ninjamar/click-to-go-robot/docs/README.md

# Documentation

| If you want... | Read |
|---|---|
| What was built, what it showed, and the lessons for the next build | [prototype-report-abridged.md](prototype-report-abridged.md) |
| To set up, run, debug or change the code | [technical-reference.md](technical-reference.md)|

Both describe the `master` branch as of October 2026. Where they disagree with the code, the code wins; please fix the document.

Photos used in the report are in `img/`.
