ninjamar/click-to-go-robot/cad/encoder_disk.stl

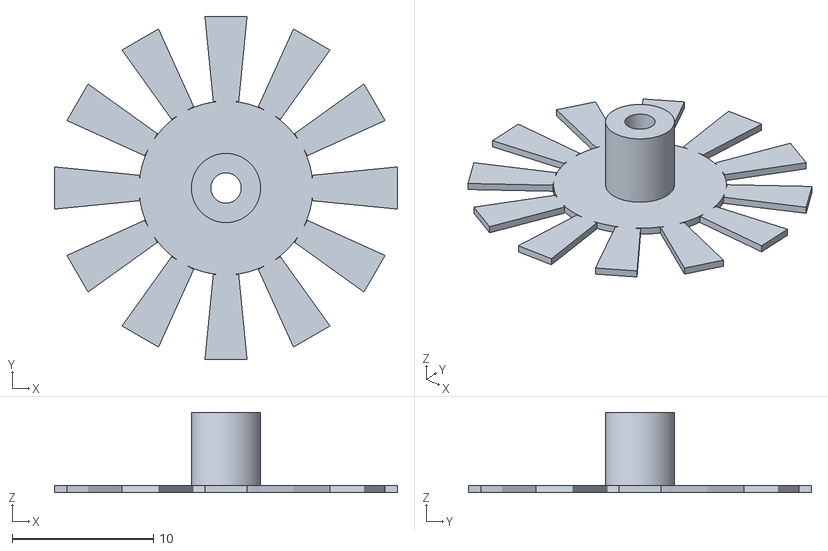
[picture p4: CAD file, 2026-08-12]
cad/encoder_disk.stl
24.3 x 24.3 x 5.70
