ninjamar/click-to-go-robot/motor_control_system/src/main.cpp

#include "config.hpp"
#include "macros.hpp"
#include "motor_driver.hpp"
#include "odometer_driver.hpp"
#include "serial_protocol.hpp"
#include <Arduino.h>
#include <math.h>

MotorDriver motorDriver(MOTOR_A_EN_PIN, MOTOR_A_IN1_PIN, MOTOR_A_IN2_PIN, MOTOR_B_EN_PIN, MOTOR_B_IN1_PIN, MOTOR_B_IN2_PIN);
OdometerDriver odometerDriver(ENCODER_MOTORA_CH_A_PIN, ENCODER_MOTORA_CH_B_PIN, ENCODER_MOTORB_CH_A_PIN, ENCODER_MOTORB_CH_B_PIN);
SerialProtocol serialProtocol(Serial);

// Command queue state
CommandPacket queue[QUEUE_SIZE]; // NOLINT(modernize-avoid-c-arrays)
// Circular buffer; avoids shifting every element on pop.
uint8_t queueHead = 0; // index of oldest item
uint8_t queueCount = 0; // number of items in queue
// tail = index where new item should be added

// Currently executing command
bool isActive = false;
CommandPacket activeCommand;
unsigned long activeStartTime = 0;
unsigned long lastTickTime = 0;

// Progress of the current chain of same-op, same-direction distance commands.
// Not reset between blended commands; accumulatedRad is reused across
// ROTATE_ANGLE and DEBUG_RUN_N_ROTATIONS (never both active at once).
float accumulatedM = 0.0f;
float accumulatedRad = 0.0f;
float chainBase = 0.0f; // summed arg of the chain's completed commands
float omegaCmd = 0.0f; // slew-limited shaft speed target

// Stall watchdog state - last progress value seen, and when.
float lastProgressValue = 0.0f;
unsigned long lastProgressTime = 0;

// Persistent signed (direction) odometry
float linearDisplacementA = 0.0f;
float linearDisplacementB = 0.0f;

float linearDistanceA = 0.0f; // magnitude
float linearDistanceB = 0.0f;

// Deferred OP_POLL_W/OP_POLL_DISTANCE request; single slot, most recent
// overwrites
bool pollPending = false;
CommandPacket pollRequest;

void setup() {
    Serial.begin(BAUD_RATE);
    odometerDriver.begin();
}

// Classifies the active command's progress-tracking style for the control tick below.
enum ActiveOpKind : uint8_t {
    KIND_TIME_MOVE, // OP_QUEUE_MOVE / OP_QUEUE_ROTATE - duration-based
    KIND_DISTANCE, // OP_QUEUE_MOVE_DIST / OP_QUEUE_ROTATE_ANGLE - wheel-geometry-based
    KIND_SHAFT_ROTATION, // OP_DEBUG_RUN_N_ROTATIONS - raw motor shaft angle
    KIND_RAW_PWM // OP_DEBUG_SET_PWM - no progress metric, runs until stopped
};

ActiveOpKind classifyOp(uint8_t op) {
    switch (op) {
        case OP_QUEUE_MOVE_DIST:
        case OP_QUEUE_ROTATE_ANGLE:
            return KIND_DISTANCE;
        case OP_DEBUG_RUN_N_ROTATIONS:
            return KIND_SHAFT_ROTATION;
        case OP_DEBUG_SET_PWM:
            return KIND_RAW_PWM;
        default: // OP_QUEUE_MOVE, OP_QUEUE_ROTATE
            return KIND_TIME_MOVE;
    }
}

// v = sqrt(2*a*d); min of accel/decel phases, capped at MAX_ANGULAR_VEL.
float computeTargetOmegaByDistance(float traveledShaftRad, float remainingShaftRad) {
    float omegaUp = sqrtf(2.0f * MAX_ANGULAR_ACCEL * max(traveledShaftRad, 0.0f));
    float omegaDown = sqrtf(2.0f * MAX_ANGULAR_ACCEL * max(remainingShaftRad, 0.0f));
    return min(min(omegaUp, omegaDown), MAX_ANGULAR_VEL);
}

// Same trapezoid, parameterized by time (no distance target available).
float computeTargetOmegaByTime(float elapsedSec, float remainingSec) {
    float omegaUp = MAX_ANGULAR_ACCEL * elapsedSec;
    float omegaDown = MAX_ANGULAR_ACCEL * max(remainingSec, 0.0f);
    return min(min(omegaUp, omegaDown), MAX_ANGULAR_VEL);
}

uint8_t pwmFromOmega(float omega) {
    float pwm = MIN_PWM + PWM_PER_RAD_S * max(omega, 0.0f);
    return static_cast<uint8_t>(constrain(pwm, MIN_PWM, MAX_PWM));
}

// True if the next queued command continues the active one without a stop.
bool queueContinuesChain() {
    return queueCount > 0 && queue[queueHead].operation == activeCommand.operation
        && queue[queueHead].direction == activeCommand.direction;
}

// Summed arg of the queued commands that continue the active chain.
float queuedChainArg() {
    float total = 0.0f;
    for (uint8_t i = 0; i < queueCount; i++) {
        const CommandPacket& c = queue[(queueHead + i) % QUEUE_SIZE];
        if (c.operation != activeCommand.operation || c.direction != activeCommand.direction) {
            break;
        }
        total += c.arg;
    }
    return total;
}

// All poll calls pass through here. Only accumulates distance if the direction
// is known (via isActive)
void pollAndAccumulate(float& w1, float& w2, float& dtSec) {
    odometerDriver.poll(w1, w2, dtSec);

    float x1 = w1 * dtSec * WHEEL_RADIUS_M / GEAR_RATIO;
    float x2 = w2 * dtSec * WHEEL_RADIUS_M / GEAR_RATIO;
    linearDistanceA += x1;
    linearDistanceB += x2;

    if (isActive) {
        auto sign = static_cast<float>(activeCommand.direction);

        linearDisplacementA += sign * x1;
        linearDisplacementB += sign * x2;
    }
}

void sendVelocityResponse(const CommandPacket& pk, ResponseStatus status) {
    float w1;
    float w2;
    float dtSec;
    pollAndAccumulate(w1, w2, dtSec);
    // Direction is only known while a command is actively driving; otherwise
    // report magnitude; see isActive
    float sign = isActive ? static_cast<float>(activeCommand.direction) : 1.0f;
    w1 *= sign;
    w2 *= sign;
    float v1 = w1 * WHEEL_RADIUS_M / GEAR_RATIO;
    float v2 = w2 * WHEEL_RADIUS_M / GEAR_RATIO;
    serialProtocol.sendResponse(pk, status, isActive, w1, w2, v1, v2, linearDistanceA, linearDistanceB, linearDisplacementA, linearDisplacementB);
}

// DEBUG: periodic pulse counts, to check whether motor A's live CH_A drops
// out in one direction. Remove once the encoder issue is resolved.
// void printDebugCounts() {
//     static unsigned long lastDebugPrint = 0;
//     unsigned long now = millis();
//     if (now - lastDebugPrint < 250) {
//         return;
//     }
//     lastDebugPrint = now;

//     unsigned long c1;
//     unsigned long c2;
//     odometerDriver.debugCounts(c1, c2);
//     Serial.print("encA chA=");
//     Serial.print(c1);
//     Serial.print("  encB chA=");
//     Serial.println(c2);
// }

void loop() {
    // printDebugCounts();

    // Intake
    CommandPacket packet;
    if (serialProtocol.readCommand(packet)) {
        switch (packet.operation) {
            // Handle non-queue operations
            case OP_STOP:
                motorDriver.stop();
                isActive = false;
                queueCount = 0; // STOP drops queued commands too
                serialProtocol.sendStatus(packet, STATUS_SUCCESS);
                break;
            case OP_POLL_W:
            case OP_POLL_DIST:
                if (!isActive) {
                    sendVelocityResponse(packet, STATUS_SUCCESS);
                } else {
                    pollPending = true;
                    pollRequest = packet;
                }
                break;
            case OP_RESET_DIST:
                linearDisplacementA = 0.0f;
                linearDisplacementB = 0.0f;
                linearDistanceA = 0.0f;
                linearDistanceB = 0.0f;

                serialProtocol.sendStatus(packet, STATUS_SUCCESS);
                break;
            default:
                // Queued operations: add them to the queue
                uint8_t totalPending = queueCount + (isActive ? 1 : 0);
                if (totalPending < QUEUE_SIZE) {
                    uint8_t tail = (queueHead + queueCount) % QUEUE_SIZE;
                    queue[tail] = packet;
                    queueCount++;
                    serialProtocol.sendStatus(packet, STATUS_OK);
                } else {
                    serialProtocol.sendStatus(packet, STATUS_REJECTED_FULL);
                }
                break;
        }
    }

    // Control tick: drive the active command's motors at the ramped PWM and
    // check for completion. Runs at most once per CONTROL_TICK_MS.
    if (isActive && millis() - lastTickTime >= CONTROL_TICK_MS) {
        unsigned long now = millis();
        unsigned long elapsedMs = now - activeStartTime;
        lastTickTime = now;

        ActiveOpKind kind = classifyOp(activeCommand.operation);

        // Call on every tick for distance
        float w1;
        float w2;
        float dtSec;
        pollAndAccumulate(w1, w2, dtSec);

        bool done = false;
        ResponseStatus doneStatus = STATUS_SUCCESS;
        float remaining = 0.0f;
        float shaftRadPerUnit = 1.0f; // unused for KIND_RAW_PWM/KIND_TIME_MOVE

        if (kind == KIND_RAW_PWM) {
            // No progress metric - this op only ends via OP_STOP or this watchdog.
            done = elapsedMs > MAX_COMMAND_MS;
            doneStatus = STATUS_TIMEOUT;
        } else if (kind == KIND_DISTANCE || kind == KIND_SHAFT_ROTATION) {
            float dt = dtSec; // actual poll window; a mid-tick poll shortens it

            if (kind == KIND_SHAFT_ROTATION) {
                // Raw shaft angle; independent of emperical constants
                accumulatedRad += fabsf(w2) * dt;

                float targetRad = activeCommand.arg * (2 * PI);
                remaining = targetRad - accumulatedRad;
                shaftRadPerUnit = 1.0f;
                done = accumulatedRad >= targetRad;
            } else {
                // Encoder A is unusable under motor drive; B is the only odometry source.
                float dsB = w2 * dt / GEAR_RATIO * WHEEL_RADIUS_M;

                // Targets are cumulative over the chain; the ramp-down plans for the
                // whole chain, including queued commands that continue it.
                float target = chainBase + activeCommand.arg;
                if (activeCommand.operation == OP_QUEUE_MOVE_DIST) {
                    accumulatedM += fabsf(dsB);

                    remaining = target + queuedChainArg() - accumulatedM;
                    shaftRadPerUnit = GEAR_RATIO / WHEEL_RADIUS_M;
                    done = accumulatedM >= target;
                } else { // OP_QUEUE_ROTATE_ANGLE
                    // In-place spin: both wheels cover the same arc, so B alone gives the angle.
                    accumulatedRad += fabsf(dsB) * 2.0f / TRACK_WIDTH_M;
                    remaining = target + queuedChainArg() - accumulatedRad;
                    shaftRadPerUnit = (TRACK_WIDTH_M / 2.0f) * GEAR_RATIO / WHEEL_RADIUS_M;
                    done = accumulatedRad >= target;
                }
            }

            if (!done) {
                if (elapsedMs > MAX_COMMAND_MS) {
                    done = true;
                    doneStatus = STATUS_TIMEOUT;
                } else {
                    // MOVE_DIST tracks accumulatedM; ROTATE_ANGLE and
                    // DEBUG_RUN_N_ROTATIONS both track accumulatedRad.
                    float progress = (activeCommand.operation == OP_QUEUE_MOVE_DIST) ? accumulatedM : accumulatedRad;
                    if (progress > lastProgressValue) {
                        lastProgressValue = progress;
                        lastProgressTime = now;
                    } else if (now - lastProgressTime > STALL_TIMEOUT_MS) {
                        done = true;
                        doneStatus = STATUS_TIMEOUT;
                    }
                }
            }
        } else { // KIND_TIME_MOVE: OP_QUEUE_MOVE or OP_QUEUE_ROTATE
            float totalMs = S_TO_MS(activeCommand.arg);
            remaining = totalMs - static_cast<float>(elapsedMs);
            done = elapsedMs >= static_cast<unsigned long>(totalMs);
        }

        if (done) {
            serialProtocol.sendStatus(activeCommand, doneStatus);
            if (doneStatus == STATUS_SUCCESS && kind == KIND_DISTANCE && queueContinuesChain()) {
                // Blend: start the next command without stopping or ramping down.
                chainBase += activeCommand.arg;
                activeCommand = queue[queueHead];
                queueHead = (queueHead + 1) % QUEUE_SIZE;
                queueCount--;
                activeStartTime = now;
            } else {
                motorDriver.stop();
                isActive = false;
            }
        } else if (kind == KIND_RAW_PWM) {
            auto pwm = static_cast<uint8_t>(constrain(activeCommand.arg, 0.0f, MAX_PWM));
            motorDriver.driveMove(activeCommand.direction, pwm);
        } else {
            uint8_t pwm;
            if (kind == KIND_TIME_MOVE) {
                pwm = pwmFromOmega(computeTargetOmegaByTime(MS_TO_S(elapsedMs), MS_TO_S(max(remaining, 0.0f))));
            } else {
                float traveled = (activeCommand.operation == OP_QUEUE_MOVE_DIST) ? accumulatedM : accumulatedRad;
                float omega = computeTargetOmegaByDistance(traveled * shaftRadPerUnit, max(remaining, 0.0f) * shaftRadPerUnit);
                // Never step up faster than the ramp, e.g. when more of the chain arrives late.
                omegaCmd = min(omega, omegaCmd + MAX_ANGULAR_ACCEL * MS_TO_S(CONTROL_TICK_MS));
                pwm = pwmFromOmega(omegaCmd);
            }
            if (activeCommand.operation == OP_QUEUE_MOVE
                || activeCommand.operation == OP_QUEUE_MOVE_DIST
                || activeCommand.operation == OP_DEBUG_RUN_N_ROTATIONS) {
                motorDriver.driveMove(activeCommand.direction, pwm);
            } else {
                motorDriver.driveRotate(activeCommand.direction, pwm);
            }
        }
    }

    // Answer a deferred poll before the next queued command dispatches.
    if (pollPending) {
        sendVelocityResponse(pollRequest, STATUS_SUCCESS);
        pollPending = false;
    }

    // Dispatch: if nothing is active and queue has items, pop front and
    // reset progress tracking. Driving starts on the next control tick.
    if (!isActive && queueCount > 0) {
        activeCommand = queue[queueHead];
        queueHead = (queueHead + 1) % QUEUE_SIZE;
        queueCount--;
        activeStartTime = millis();
        lastTickTime = activeStartTime - CONTROL_TICK_MS; // fire the first tick immediately
        accumulatedM = 0.0f;
        accumulatedRad = 0.0f;
        chainBase = 0.0f;
        omegaCmd = 0.0f;
        lastProgressValue = 0.0f;
        lastProgressTime = activeStartTime;
        isActive = true;
    }
}
