ninjamar/click-to-go-robot/(commit log)

2026-07-15 Add motor driver base
2026-07-15 remove enable pin
2026-07-16 fix packing issue with structs
    [main.cpp]
2026-07-16 use two motors instead of one
2026-07-24 update motors
2026-07-27 setup ros2 environment using docker
    [compose.hardware.yaml]
2026-07-28 Add ros2 code
    [compose.hardware.yaml, controller_params.yaml]
2026-07-28 update ros2 and add codegen for ros2 config
    [controller_params.yaml, hardware.yaml]
2026-07-29 update ros2
    [compose.hardware.yaml, hardware.yaml]
2026-08-05 update motor control bridge ros node
2026-08-05 orient lidar properly in ros
2026-08-05 Disable encoder A
2026-08-06 Redesign trapezoidal speed curve and re-enable encoder A
    [bridge_node.py, calibrate.py, config.hpp, main.cpp]
2026-08-06 Add scad for encoder disk
    [encoder_disk.scad]
2026-08-12 fix encoder disk A
    [encoder_disk.scad, encoder_disk.stl]
2026-10-17 use encoder B only as encoder A is broken
    [main.cpp]
2026-10-22 add attach usb recipe to justfile
2026-10-22 update codebase; robot responds and moves to goal successfully
    [hardware.yaml]
2026-10-22 use blending for command execution in the motor control system
    [hardware.yaml]
2026-10-25 update code
    [compose.hardware.yaml]
